vzffvr/SAE-S5/Algorigrammes/Touradou/Conception/Screenshot_2025-02-08-12-51-37-31_17a14d8a427711cae89d3a5275d1533a.jpg

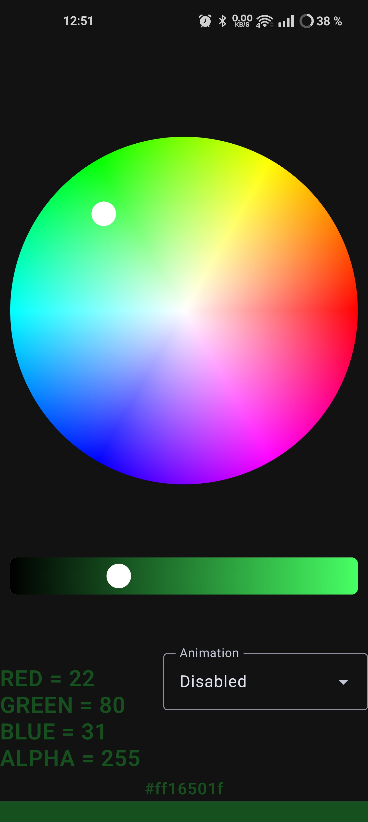
Algorigrammes/Touradou/Conception/Screenshot_2025-02-08-12-51-37-31_17a14d8a427711cae89d3a5275d1533a.jpg
