vzffvr/SAE-S5/Algorigrammes/Touradou/Conception/Algo lecture boutton.png

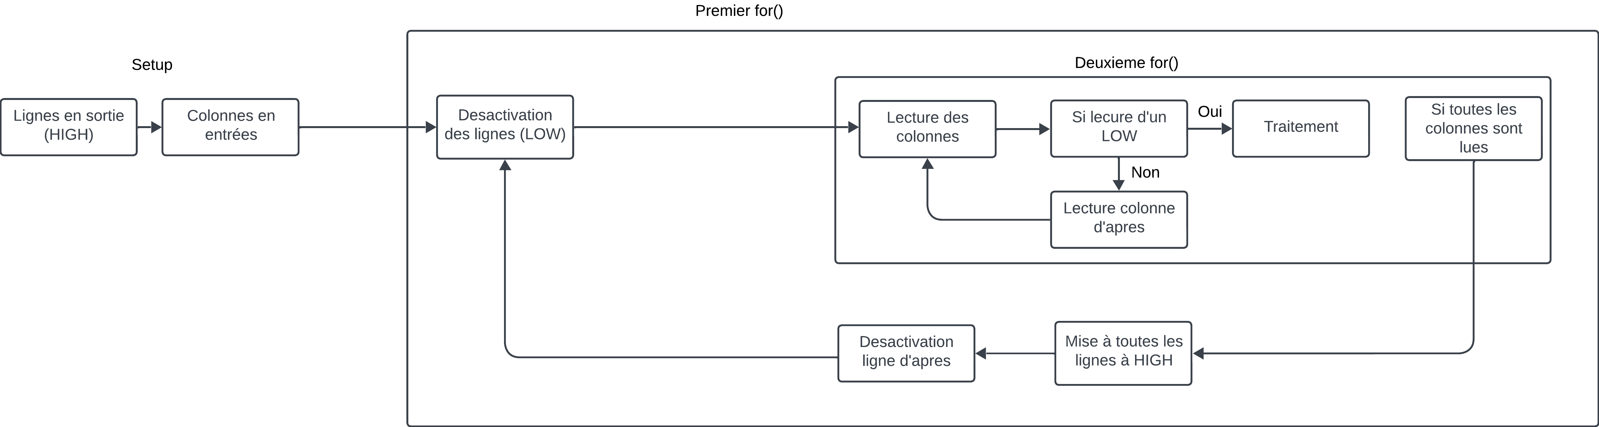
Algorigrammes/Touradou/Conception/Algo lecture boutton.png
