vzffvr/SAE-S5/Algorigrammes/Touradou/Conception/App.png

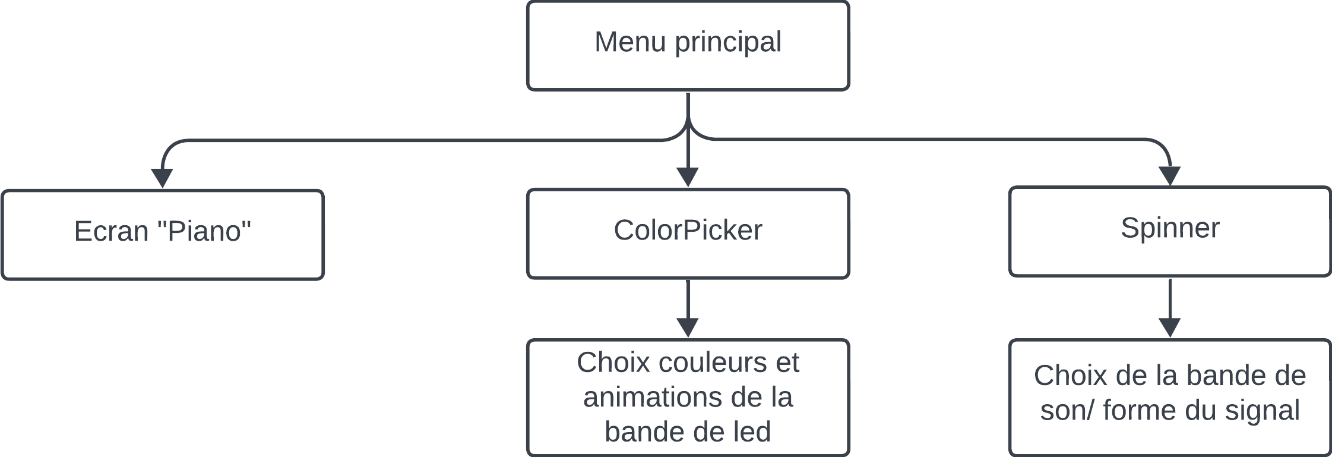
Algorigrammes/Touradou/Conception/App.png
