vzffvr/SAE-S5/Algorigrammes/Touradou/Conception/detection de touches.png

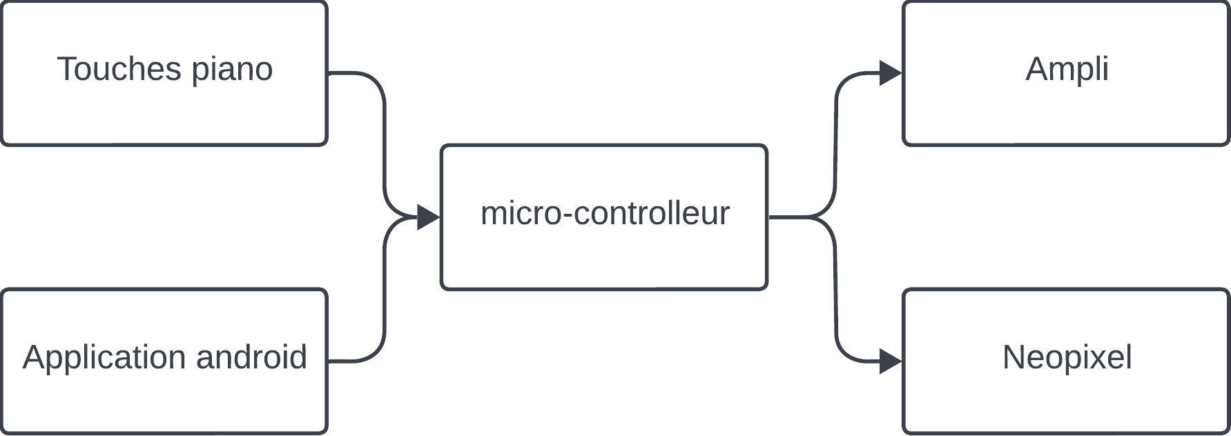
Algorigrammes/Touradou/Conception/detection de touches.png
