vzffvr/SAE-S5/Algorigrammes/Touradou/Conception/Optimisation memoire.png

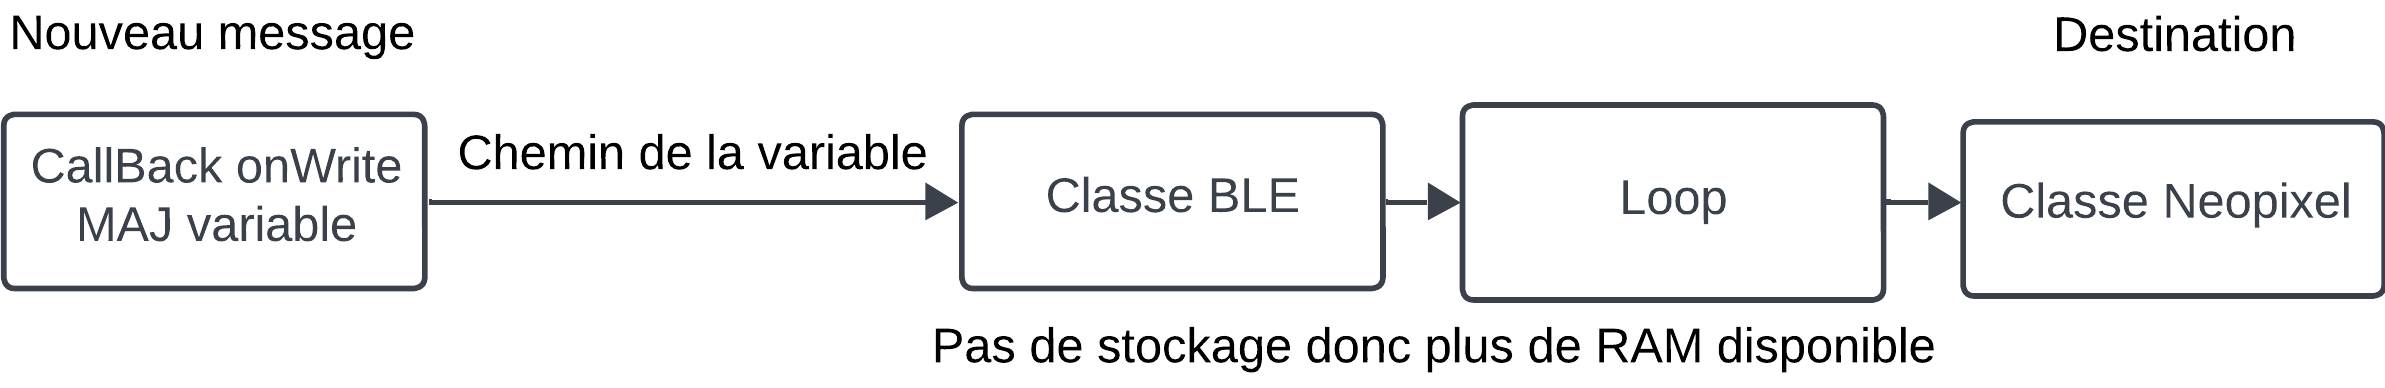
Algorigrammes/Touradou/Conception/Optimisation memoire.png
