vzffvr/SAE-S5/Algorigrammes/Touradou/Conception/Serveur GATT.png

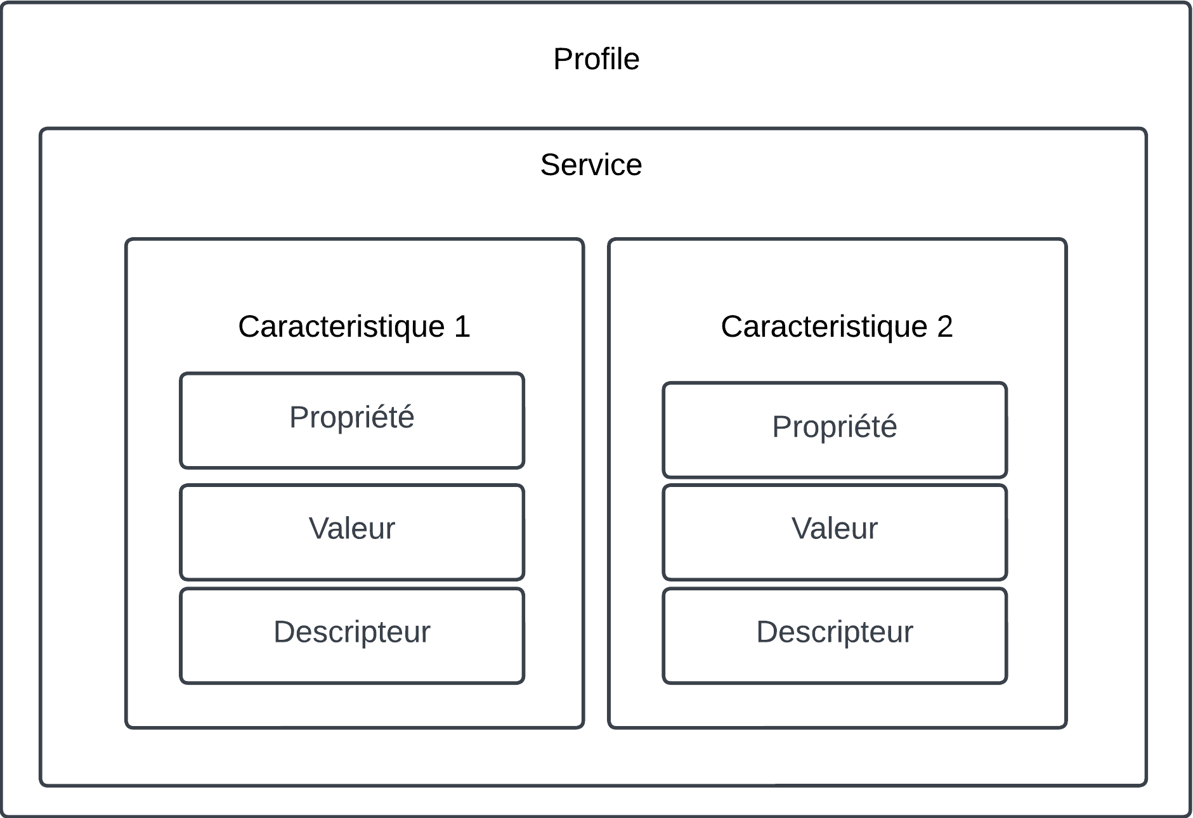
Algorigrammes/Touradou/Conception/Serveur GATT.png
