vzffvr/SAE-S5/Dossiers/Liste de composant KANE KANIA MARTIN.xlsx

Nom du composant | Prix | Lien
ESP32 S3-Devkit C | 13.99 € | https://www.amazon.fr/ESP32-S3-d%C3%A9veloppement-Binghe-ESP32-S3-DevKitC-1-WROOM-1-N16R8/dp/B0D6B614M8
Bobine de filament PLA Matte Noir | 23.18 € | https://eu.store.bambulab.com/fr-fr/collections/all/products/pla-matte-filament?variant=42996742750427
Ampli audio 3W 8ohms | 6.31 € | https://www.amazon.fr/Amplificateur-2-5V-5-5V-dAmplificateur-Puissance-Amplifier/dp/B08D9MGHM2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
haut parleur 3w 8ohms | 5.91 € | https://www.mouser.fr/ProductDetail/Same-Sky/CMS-3118-38E?qs=IKkN%2F947nfB5KUQR4YXCyg%3D%3D
entretoises
connecteur femelle jack DC 5,5X2,1 | 3.49 | https://www.amazon.fr/BIlinli-DC-005-Connecteur-5-5x2-1mm-Barrel/dp/B082B7VQRY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
chargeur 12v | 11.97 | https://www.amazon.fr/Adaptateur-Alimentation-dalimentation-adaptateurs-convertisseur/dp/B09KNC7SDQ
ressorts (X5) | 6.86 | https://fr.rs-online.com/web/p/ressorts-de-compression/0751512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
