vzffvr/SAE-S5/fichier STL clavier V6/cache_avant_gauche.stl

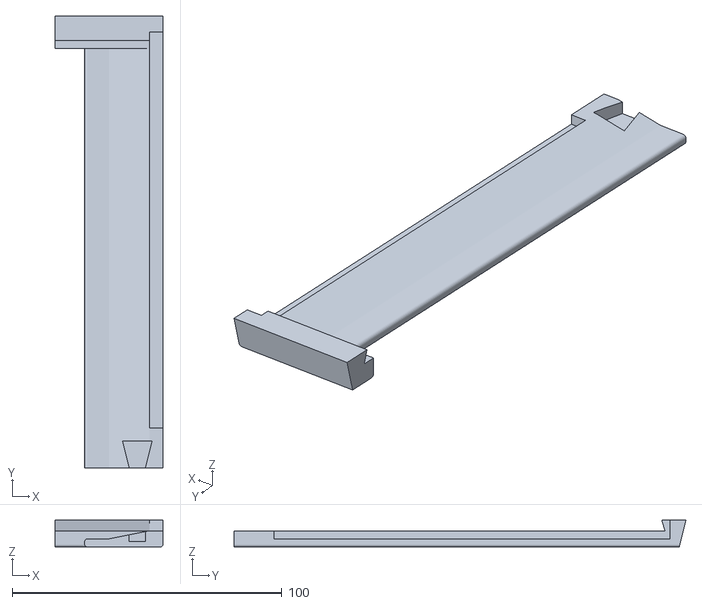
[picture p38: CAD file, 2025-03-02]
fichier STL clavier V6/cache_avant_gauche.stl
40.0 x 167.5 x 10.0
