vzffvr/SAE-S5/impression/Reste touche blanche + caches.3mf

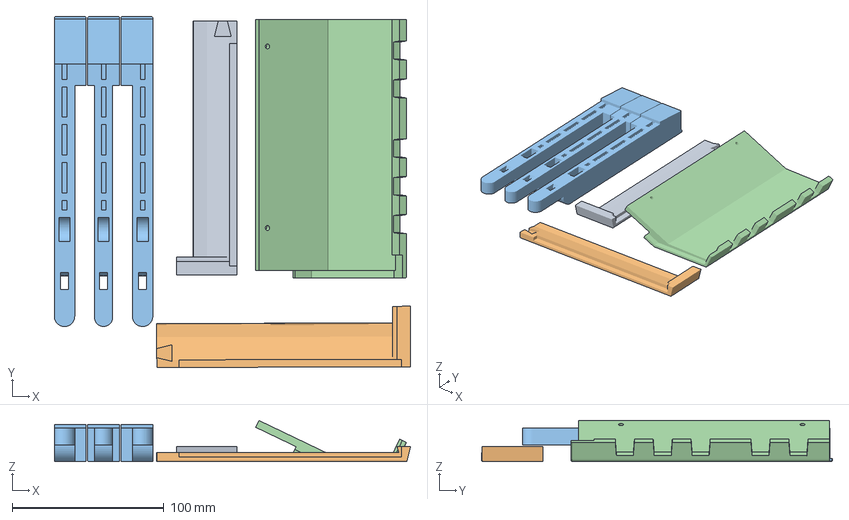
[picture p39: CAD file, 2025-03-05]
impression/Reste touche blanche + caches.3mf
235.1 x 231.5 x 27.1 mm
cache_avant_droit.stl
cache_avant_gauche.stl
octave_touches_blanches.stl_A
capot_droit.stl
