vzffvr/SAE-S5/impression/Reste Supports.3mf

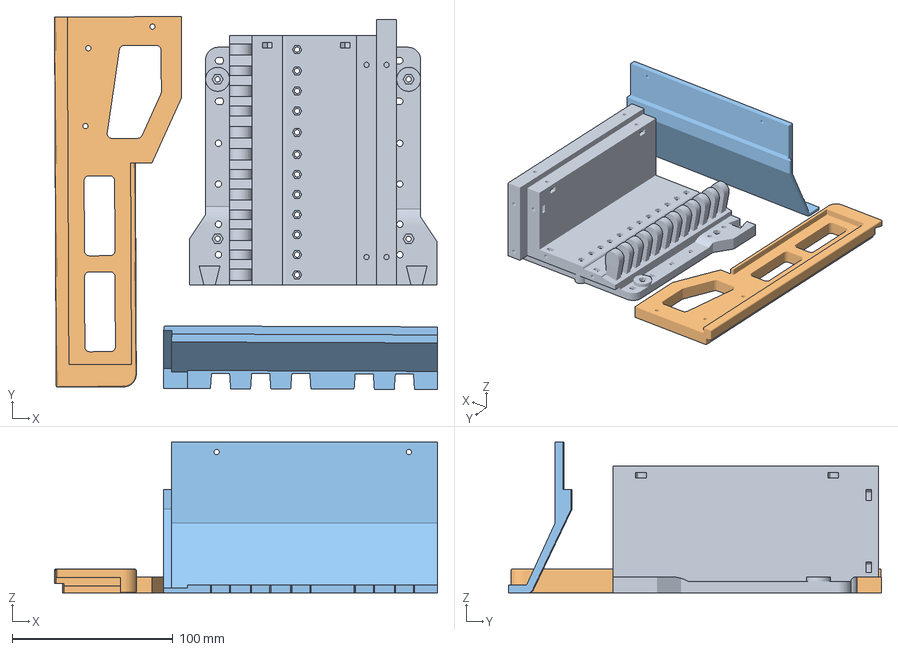
[picture p40: CAD file, 2025-03-04]
impression/Reste Supports.3mf
238.6 x 232.3 x 94.0 mm
support_partie_gauche.stl
cache_gauche.stl
capot_droit.stl
