vzffvr/SAE-S5/fichier STL clavier V6/capot_gauche.stl

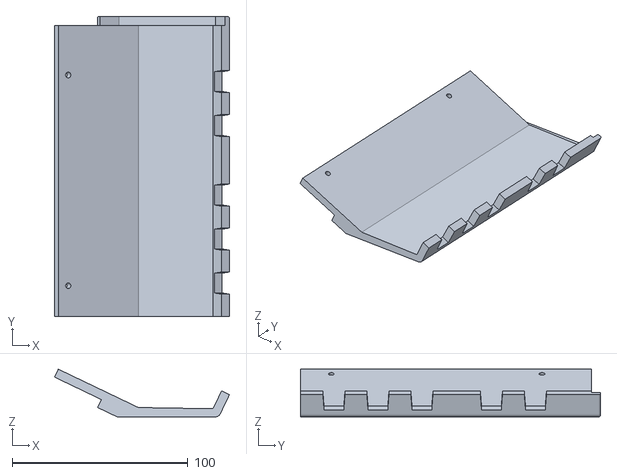
[picture p41: CAD file, 2025-03-02]
fichier STL clavier V6/capot_gauche.stl
99.5 x 170.5 x 27.1
