vzffvr/SAE-S5/impression/11 touches blanches.3mf

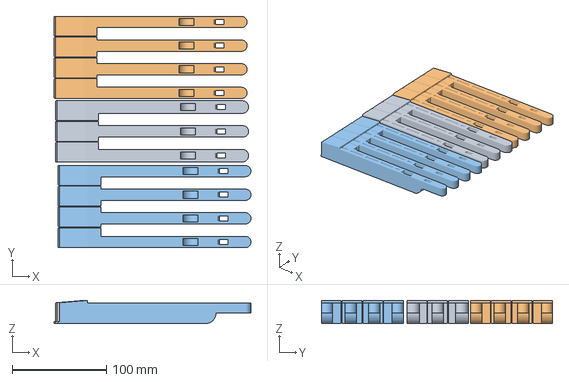
[picture p42: CAD file, 2025-03-03]
impression/11 touches blanches.3mf
208.6 x 244.8 x 24.5 mm
octave_touches_blanches.stl_A
octave_touches_blanches.stl_B x 2
