vzffvr/SAE-S5/fichier STL clavier V6/octave_touches_blanches.stl

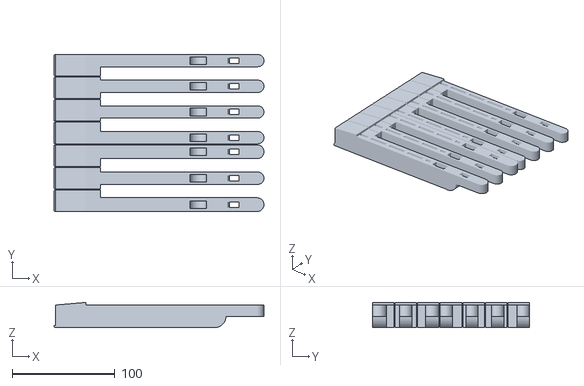
[picture p43: CAD file, 2025-03-02]
fichier STL clavier V6/octave_touches_blanches.stl
204.5 x 153.0 x 24.5
