vzffvr/SAE-S5/impression/Gros du support.3mf

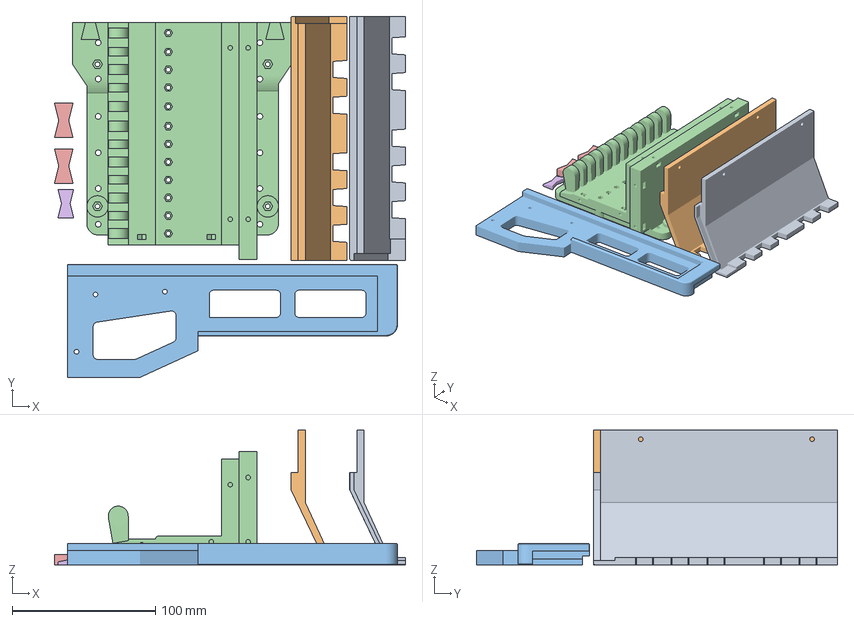
[picture p44: CAD file, 2025-03-03]
impression/Gros du support.3mf
245.3 x 252.3 x 94.0 mm
capot_droit.stl
capot_gauche.stl
cache_droit.stl
support_partie_droite.stl
queues_d_aronde.stl_A
queues_d_aronde.stl_B
