vzffvr/SAE-S5/(list of files, cad)

Other CAD files:
fichier STL clavier V6/cache_avant_droit.stl
fichier STL clavier V6/capot_droit.stl
