vzffvr/SAE-S5/PCB Symphonie/PDFs/PCB Symphonie.pdf

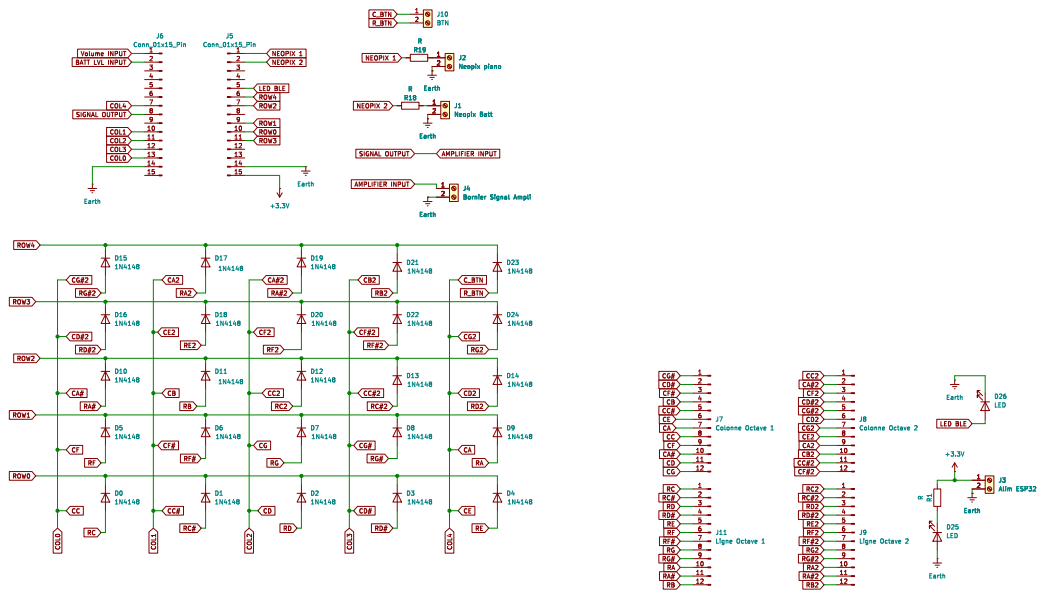
[picture p55: page 1]
