vzffvr/SAE-S5/PCB Symphonie/PCB Symphonie.kicad_pcb

## KiCad design PCB Symphonie/PCB Symphonie.kicad_pcb (2025-04-27)

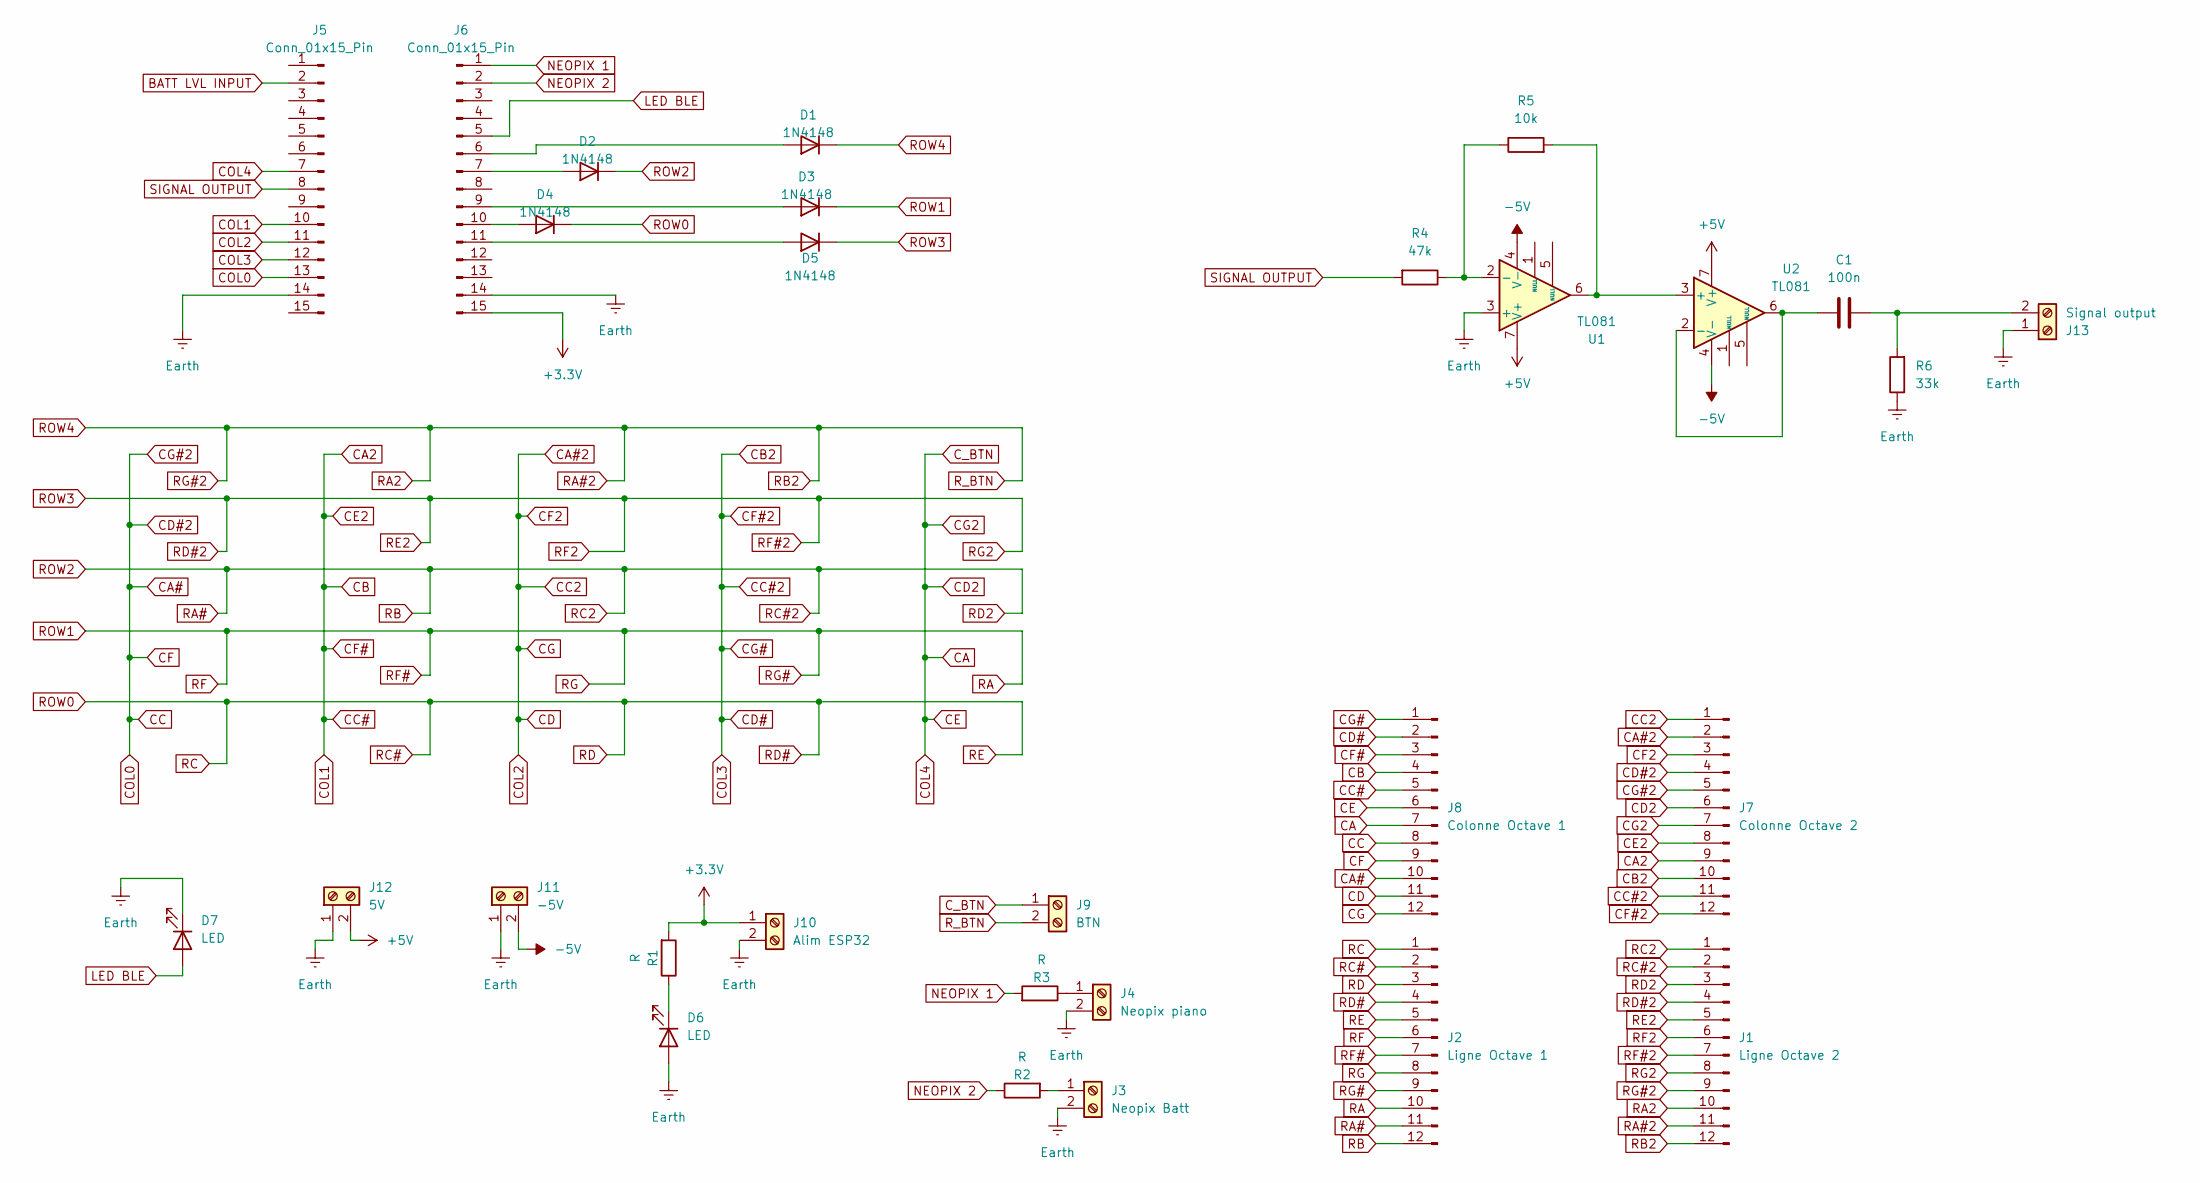
[picture p56: schematic PCB Symphonie.kicad_sch]

Parts:
C1: 100n; C_Rect_L7.0mm_W2.0mm_P5.00mm
D1, D2, D3, D4, D5: 1N4148; D_DO-35_SOD27_P7.62mm_Horizontal
D6, D7: LED; LED_D3.0mm
J1: Ligne Octave 2; PinSocket_1x12_P2.54mm_Vertical
J2: Ligne Octave 1; PinSocket_1x12_P2.54mm_Vertical
J3: Neopix Batt; TerminalBlock_MaiXu_MX126-5.0-02P_1x02_P5.00mm
J4: Neopix piano; TerminalBlock_MaiXu_MX126-5.0-02P_1x02_P5.00mm
J5, J6: Conn_01x15_Pin; PinHeader_1x15_P2.54mm_Vertical
J7: Colonne Octave 2; PinSocket_1x12_P2.54mm_Vertical
J8: Colonne Octave 1; PinSocket_1x12_P2.54mm_Vertical
J9: BTN; TerminalBlock_MaiXu_MX126-5.0-02P_1x02_P5.00mm
J10: Alim ESP32; TerminalBlock_MaiXu_MX126-5.0-02P_1x02_P5.00mm
J11: -5V; TerminalBlock_MaiXu_MX126-5.0-02P_1x02_P5.00mm
J12: 5V; TerminalBlock_MaiXu_MX126-5.0-02P_1x02_P5.00mm
J13: Signal output; TerminalBlock_MaiXu_MX126-5.0-02P_1x02_P5.00mm
R1, R2, R3: R; R_Axial_DIN0204_L3.6mm_D1.6mm_P7.62mm_Horizontal
R4: 47k; R_Axial_DIN0207_L6.3mm_D2.5mm_P7.62mm_Horizontal
R5: 10k; R_Axial_DIN0207_L6.3mm_D2.5mm_P7.62mm_Horizontal
R6: 33k; R_Axial_DIN0207_L6.3mm_D2.5mm_P7.62mm_Horizontal
U1, U2: TL081; DIP-8_W7.62mm_Socket

Connections:
+3.3V: J6.15, J10.1, R1.2
+5V: J12.2, U1.7 (V+), U2.7 (V+)
-5V: J11.2, U1.4 (V-), U2.4 (V-)
BATT LVL INPUT: J5.2
CA: J5.7, J7.6, J7.7, J8.6, J8.7, J9.1
CA2: J5.10, J7.8, J7.9, J8.3, J8.4, J8.5
CA#: J5.13, J7.4, J7.5, J8.8, J8.9, J8.10
CA#2: J5.11, J7.1, J7.2, J7.3, J8.11, J8.12
CB2: J5.12, J7.10, J7.11, J7.12, J8.1, J8.2
Earth: D6.2 (A), D7.1 (K), J3.2, J4.2, J5.14, J6.14, J10.2, J11.1, J12.1, J13.1, R6.1, U1.3 (+)
LED BLE: D7.2 (A), J6.5
NEOPIX 1: J6.1, R3.2
NEOPIX 2: J6.2, R2.1
unnamed: D1.2 (A), J6.6
unnamed: D2.2 (A), J6.7
unnamed: D3.2 (A), J6.9
unnamed: D4.2 (A), J6.10
unnamed: D5.2 (A), J6.11
unnamed: D6.1 (K), R1.1
unnamed: J3.1, R2.2
unnamed: J4.1, R3.1
unnamed: C1.2, J13.2, R6.2
unnamed: R4.1, R5.1, U1.2 (-)
unnamed: R5.2, U1.6, U2.3 (+)
unnamed: C1.1, U2.2 (-), U2.6
RA: D3.1 (K), J2.6, J2.7, J2.8, J2.9, J2.10
RA#: D2.1 (K), J1.1, J1.2, J1.3, J2.11, J2.12
RA#2: D1.1 (K), J1.9, J1.10, J1.11, J1.12, J9.2
RC: D4.1 (K), J2.1, J2.2, J2.3, J2.4, J2.5
RD#2: D5.1 (K), J1.4, J1.5, J1.6, J1.7, J1.8
SIGNAL OUTPUT: J5.8, R4.2

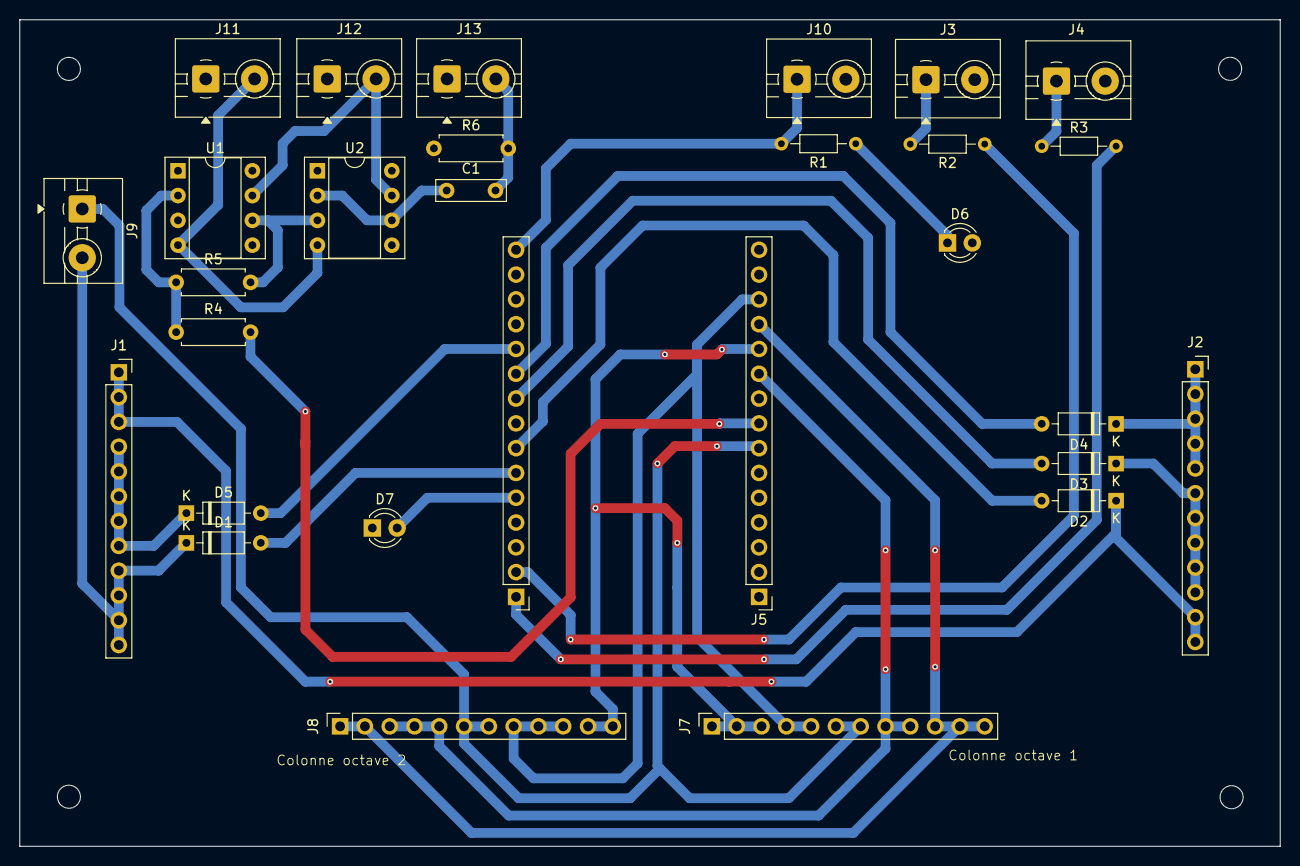
[picture p57: board PCB Symphonie.kicad_pcb from above]

Board: 2 copper layers, 129.1 x 84.7 mm, 29 parts (0 on the bottom side), 30 nets.
