vzffvr/SAE-S5/Mise a niveau signal/Mise a niveau signal.kicad_pcb

## KiCad design Mise a niveau signal/Mise a niveau signal.kicad_pcb (2025-04-04)

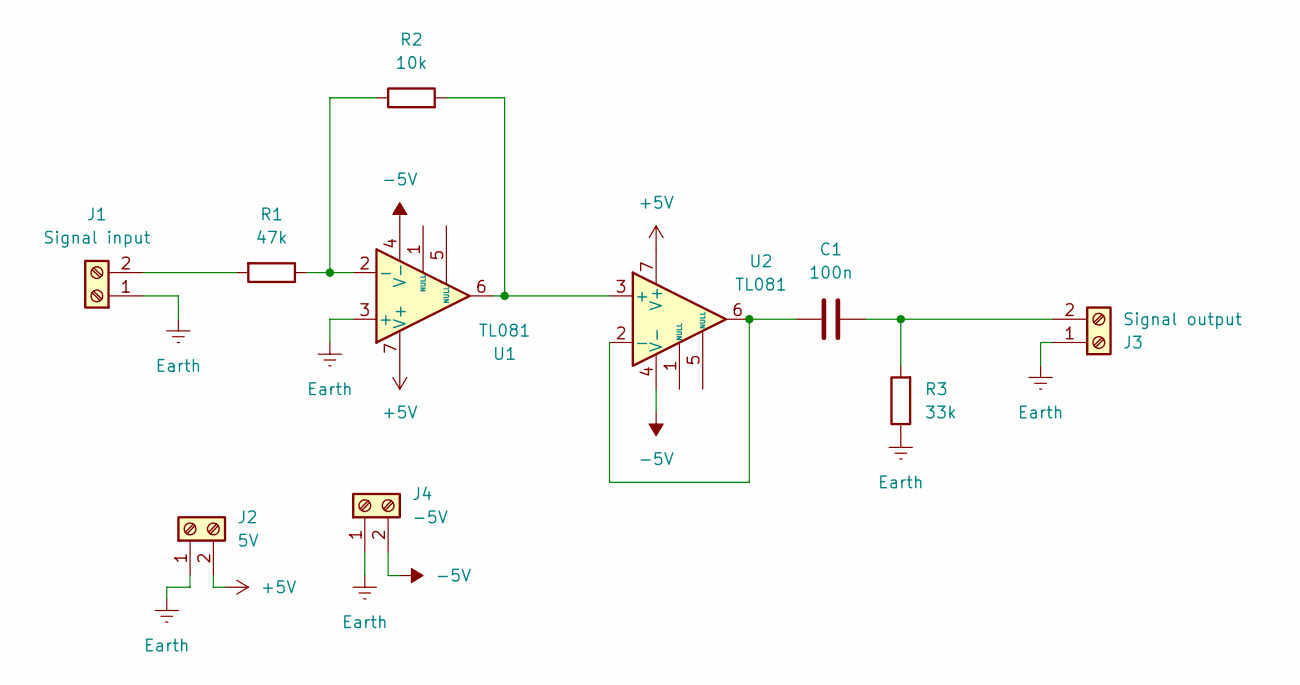
[picture p58: schematic Mise a niveau signal.kicad_sch]

Parts:
C1: 100n; C_Rect_L7.0mm_W2.0mm_P5.00mm
J1: Signal input; TerminalBlock_MaiXu_MX126-5.0-02P_1x02_P5.00mm
J2: 5V; TerminalBlock_MaiXu_MX126-5.0-02P_1x02_P5.00mm
J3: Signal output; TerminalBlock_MaiXu_MX126-5.0-02P_1x02_P5.00mm
J4: -5V; TerminalBlock_MaiXu_MX126-5.0-02P_1x02_P5.00mm
R1: 47k; R_Axial_DIN0207_L6.3mm_D2.5mm_P7.62mm_Horizontal
R2: 10k; R_Axial_DIN0207_L6.3mm_D2.5mm_P7.62mm_Horizontal
R3: 33k; R_Axial_DIN0207_L6.3mm_D2.5mm_P7.62mm_Horizontal
U1, U2: TL081; DIP-8_W7.62mm_Socket

Connections:
+5V: J2.2, U1.7 (V+), U2.7 (V+)
-5V: J4.2, U1.4 (V-), U2.4 (V-)
Earth: J1.1, J2.1, J3.1, J4.1, R3.1, U1.3 (+)
unnamed: J1.2, R1.2
unnamed: C1.2, J3.2, R3.2
unnamed: R1.1, R2.1, U1.2 (-)
unnamed: R2.2, U1.6, U2.3 (+)
unnamed: C1.1, U2.2 (-), U2.6

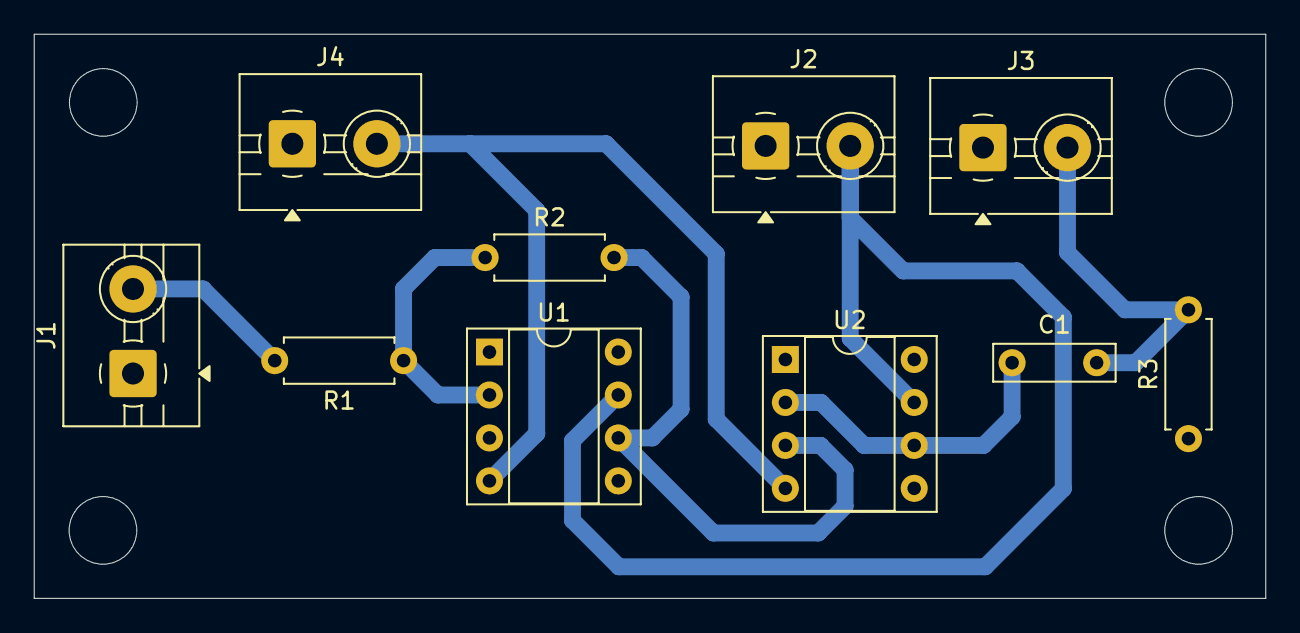
[picture p59: board Mise a niveau signal.kicad_pcb from above]

Board: 2 copper layers, 72.8 x 33.4 mm, 10 parts (0 on the bottom side), 8 nets.
