vzffvr/SAE-S5/(commit log)

2024-09-25 Debut analyse fonctionelle et cahier des charges
2024-10-21 Fin seance21/10
    Mise en place logo Light and dark tehem
    [Liste de composant KANE KANIA MARTIN.xlsx]
2024-10-27 MAJ cahier des charges et liste de composants
    [Liste de composant KANE KANIA MARTIN.xlsx]
2024-10-27 Update Liste de composant KANE KANIA MARTIN.xlsx
    [Liste de composant KANE KANIA MARTIN.xlsx]
2024-11-18 Fin, seance 18/11
    Implementation clavier fini maj colorpicker screen pour fit tout les ecrans,pb pour le mainscreen quand on change dp en fraction les button ne font plus la meme taille.
2024-11-26 Cablage ok PB de selection de ligne
    Si seulement 1 chiffre c est seulement que le 0 est effacé par la fonction serial. Si 2 alors col 0 ligne 2
2024-11-28 R1 et 2 ok
    R0 nok a cause des leds. Ajout millis, res pulldown R voir shma
    [Carte matrice.kicad_pcb, Carte matrice.kicad_sch]
2025-01-12 Create impression touches V1 SAE S5.stl
    [impression touches V1 SAE S5.stl]
2025-01-19 Create impression support V1 SAES5.stl
    [impression support V1 SAES5.stl]
2025-01-27 code bleutooth
    [impression support V1 SAES5.3mf]
2025-01-30 30/01 BLE OK
    BLE Connection ok caracteristique et service trouve faire envoi
    [Carte matrice.kicad_sch]
2025-01-31 Debut changement des pages MQTT -> BLE
2025-02-02 Connection et envoie OK
    Debut cahier de conception
    Connection et envoie BLE OK
    bouton reconnect OK
    Faire envoie touches piano
    [Carte matrice.kicad_sch]
2025-02-07 Recup toutes donnees ok Utilisable dans la loop
2025-02-09 Create Dossier de conception V1.3.docx
2025-02-09 Correction diff erreurs
    La plupart des anims sont ok,Faire reverse colorWipeCenter, colorWipeEdge.
    Inversion green et blue.
    Anim Suiveur marchje pas du tout
    Faire slider vitesse wipe
    [main.cpp, main.h]
2025-02-09 Create Cahier des charges SAE S5 V2.docx
2025-02-15 Multi touche
    Ajouter l'incrementation de la velocite
2025-02-16 Debut Schema Symphonie, Fin dossier de fab et nettoyage
    [Carte matrice.kicad_pcb, Carte matrice.kicad_sch, Liste de composant KANE KANIA MARTIN.xlsx, PCB Symphonie.kicad_pcb, PCB Symphonie.kicad_sch]
2025-02-18 MAJ pcb
    ajout alim remplacement esp32 par connecteur
    Verifier taille condensateur (polarisation),
    demander a augustin res de puissances,
    replacer bouttons par piste et bornier
    [PCB Symphonie.kicad_pcb, PCB Symphonie.kicad_sch]
2025-02-18 MAJ Pin changement shematique verifier empreintes
    [PCB Symphonie.kicad_pcb, PCB Symphonie.kicad_sch]
2025-02-24 True multi button, correction pins pour row, et changmenet de nb max d appuie selon un define
    Peut etre cause du pb de signal bizarre
    [main.cpp, main.h]
2025-02-25 Modif shema, Alim fait par simon
    Debut PCB
    [Carte Alim.kicad_pcb, Carte Alim.kicad_sch, PCB Symphonie.kicad_pcb, PCB Symphonie.kicad_sch]
2025-02-26 maj pcb
    [PCB Symphonie.kicad_pcb, PCB Symphonie.kicad_sch]
2025-03-02 Routage bien avancer ajout mode auto
    [PCB Symphonie.kicad_pcb, PCB Symphonie.kicad_sch]
2025-03-02 fichiers stl à imprimer
    [cache_avant_droit.stl, cache_avant_gauche.stl, cache_droit.stl, cache_gauche.stl, capot_droit.stl, capot_gauche.stl, octave_touches_blanches.stl, octave_touches_noires.stl]
2025-03-03 Creation diff fichier d'impressions, MAJ app pour selection channel, 3/4 dossier procedure et rapport de tests
    [11 touches blanches.3mf, Gros du support.3mf, Reste Supports.3mf, Reste touche blanche + caches.3mf, cache_droit.stl, cache_gauche.stl, capot_droit.stl, capot_gauche.stl]
2025-03-04 debut cours 4mars
    [Reste Supports.3mf, Reste touche blanche + caches.3mf]
2025-03-04 Fin cours 4mars
    [PCB Symphonie.kicad_pcb, PCB Symphonie.kicad_sch]
2025-03-05 Modif proc de test rapport de test a faire
    Correction bug retour en arriere melodie screeen
    [PCB Symphonie-B_Cu.gbr, PCB Symphonie-B_Mask.gbr, PCB Symphonie-B_Paste.gbr, PCB Symphonie-B_Silkscreen.gbr, PCB Symphonie-Edge_Cuts.gbr, PCB Symphonie-F_Cu.gbr, PCB Symphonie-F_Mask.gbr, PCB Symphonie-F_Paste.gbr]
2025-03-06 Rapport de tests
2025-04-04 Maj de bcp de truc
    [Mise a niveau signal-B_Cu.gbr, Mise a niveau signal-B_Mask.gbr, Mise a niveau signal-B_Paste.gbr, Mise a niveau signal-B_Silkscreen.gbr, Mise a niveau signal-Edge_Cuts.gbr, Mise a niveau signal-F_Cu.gbr, Mise a niveau signal-F_Mask.gbr, Mise a niveau signal-F_Paste.gbr]
2025-04-27 Carte elec
    [PCB Symphonie.kicad_pcb, PCB Symphonie.kicad_sch]
2025-04-28 ajout STL
    [capot_droit.stl, capot_gauche.stl]
2025-04-30 Reglement probleme de non suppression du tableau des touche du tableau
    [main.cpp, main.h]
